aasameh/conv_3x3/doc/report.pdf

# A Zero-BRAM, Single-Cycle Streaming 2D Convolution Accelerator with Saturating ReLU Datapath for Edge-AI Vision

Ahmed S. Bassala¹
1Department of Electronics and Communications Engineering, Egypt-Japan University of Science and Technology (E-JUST)

Abstract—This paper presents the digital architecture, hardware implementation, and systematic verification of an area- and energy-efficient 2D convolutional accelerator tailored for edge-AI vision applications. Operating on single-channel 32 × 32 image frames, the accelerator evaluates a runtime-programmable 3 × 3 spatial kernel with 8-bit unsigned pixel activations and 8-bit signed weights. By implementing line buffers via look-up table shift registers (SRL32), Block RAM utilization is strictly eliminated (BRAM = 0), avoiding severe Figure-of-Merit (FoM) penalties. The pipelined datapath couples a parallel LUT-based multiplier array with a balanced combinational adder tree and saturating post-processing with optional Rectified Linear Unit (ReLU) activation. Implemented Out-of-Context on a Xilinx Artix-

### 7 FPGA (xc7a35tcpg236-1), the core delivers a sustained

throughput of 1.0 output pixel/clock cycle after an initial latency of 69 cycles, closing at 100.01 MHz, and achieving an on-chip power consumption of 75 mW (0.075 W), and an optimized Figure of Merit of 0.01734 pixel/(W · Cost).

Index Terms—Convolutional Neural Networks, 2D FIR Filter, FPGA, Edge-AI, Line Buffers, SRL32, Saturation Arithmetic, Figure of Merit.

I. SPECIFICATIONS AND ARCHITECTURAL ASSUMPTIONS
To satisfy all mandatory contest requirements while establishing rigorous bounds for hardware sizing, the parameters in Table I govern the design.

TABLE I
SYSTEM SPECIFICATIONS
Parameter | Design Choice | Justification
Input Resolution | 32 × 32 pixels | Minimum spec-compliant resolution.
Input Precision | 8-bit Unsigned ([0, 255]) | Native | dynamic | range | of
monochrome image sensors (standard grayscale range).
Kernel Dimensions | 3 × 3 (N = 3) | Dominant spatial filter size across
modern convolutional neural network
| | backbones.
Kernel Precision | 8-bit Signed ([−128, 127]) | Specification.
Stride | S = 1 | Specification.
Output Precision | 16-bit Signed | Minimum spec-compliant precision.
Boundary Policy | Valid-Region (30 × 30) | Avoids artificial zero-padding distor-
| | tion.
Activation Function | Saturating ReLU | Bonus feature; implements non-linear
activation f(x) = max(0, x) at almost zero logic overhead.

II. ARCHITECTURE OVERVIEW
The accelerator is partitioned into six distinct structural units, as illustrated in the top-level block diagram (Fig. 1):
1) Configuration Port: A 4-bit addressed write interface (cfg_we, cfg_addr, cfg_wdata) that loads weights into the internal 3 × 3 coefficient matrix prior to frame execution.
2) Dual Line Buffers (lb0, lb1): Shift register storage buffering 2 × (W − 3) pixels, aligning three consecutive vertical image rows.
3) Sliding Window Generator: A 3 × 3 flip-flop array that captures spatial neighborhoods on every active clock cycle.
4) Parallel Multiplier Core: Nine parallel fabric multipliers calculating signed products between unsigned pixels and signed weights without dedicated DSP slices ((*
use_dsp = "no" *)).
5) Balanced Adder Tree: A 4-level combinational tree accumulating 9 products into an overflow-free 20-bit signed sum (acc_comb).
6) Saturating Post-Processor: Dual-threshold comparator clamping values to signed 16-bit limits, cascaded into an optional sign-bit ReLU gate.

III. DATAPATH AND BIT-WIDTH ANALYSIS

A. Multiplier Dynamic Range

The input pixels are unsigned values Xi,j ∈ [0, 255] represented as logic [7:0]. In the multiplier array, each pixel is concatenated with a leading zero to cast it into a non-negative 9-bit signed integer:

Xext = $signed({1

′
b0, win[r][2 − c]}) ∈ [0, +255] (1)

The programmable kernel taps Wm,n ∈ [−128, +127] are 8-bit signed two’s complement integers sign-extended to 9 bits. The resulting product dynamic range is:

Pmin = 255 × (−128) = −32, 640 | (2)
Pmax = 255 × (+127) = +32, 385 | (3)

Because −2

15 = −32, 768 ≤ Pmin < Pmax ≤ +32, 767 = 2

15 − 1, every individual product strictly fits within a standard 16-bit signed container. In RTL, the multiplier outputs are regis-
tered directly as logic signed [15:0] prod[3][3].

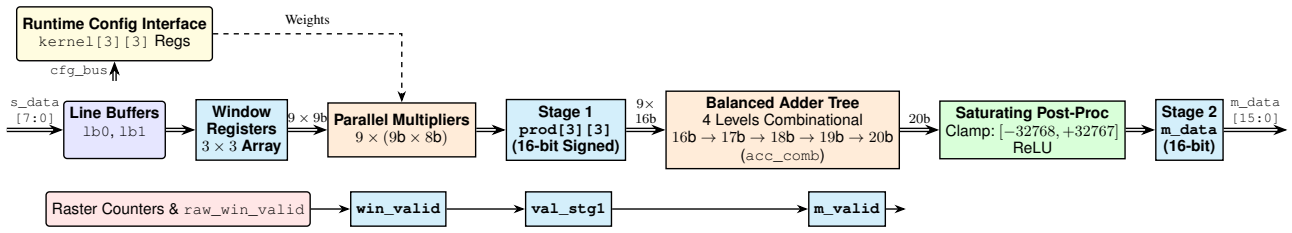
[picture p1: figure]
Line Buffers lb0, lb1; Window Registers 3 × 3 Array; Parallel Multipliers 9 × (9b × 8b); Stage 1; prod[3][3] (16-bit Signed); Balanced Adder Tree 4 Levels Combinational 16b → 17b → 18b → 19b → 20b (acc_comb); Saturating Post-Proc Clamp: [−32768, +32767] ReLU; Stage 2; m_data (16-bit); Runtime Config Interface kernel[3][3] Regs; s_data; m_data [15:0]; cfg_bus; Weights; Raster Counters & raw_win_valid; win_valid; val_stg1; m_valid

Fig. 1. Complete hardware architecture and pipelined datapath of the convolution accelerator, detailing signal bit-growth and synchronous valid-strobe tracking.

B. Adder Tree Dynamic Range

The accumulator sums nine parallel 16-bit signed products:

Sacc =

∑︂

2

r=0

∑︂

2

c=0

Pr,c | (4)

The theoretical worst-case accumulation extrema evaluate to:

Smin = 9 × (−32, 640) = −293, 760 | (5)
Smax = 9 × (+32, 385) = +291, 465 | (6)

The minimum bit-width required to contain this complete sum without arithmetic overflow is:

Bacc = 1 + ⌈log2

(293, 760)⌉ = 1 + 19 = 20 bits (7)

The datapath implements an exact 20-bit signed accu-
mulator (logic signed [19:0] acc_comb) spanning
[−524, 288, +524, 287]. This provides full mathematical protection against intermediate overflow while maintaining optimal slice logic utilization.

TABLE II
BIT-WIDTH PROGRESSION ACROSS DATAPATH STAGES
Stage / Signal | Representation | Bit Container | Absolute Dynamic Range
Input Pixel (s_data) | Unsigned | logic [7:0] | [0, 255]
Sign-Ext Pixel (win) | Signed Positive | logic signed [8:0] | [0, +255]
Kernel Weight (kernel) | Signed 2’s Comp | logic signed [7:0] | [−128, +127]
Product Pr,c (prod) | Signed 2’s Comp | logic signed [15:0] | [−32640, +32385]
Adder Level 1 (lvl1_sum*) | Signed 2’s Comp | logic signed [16:0] | [−65280, +64770]
Adder Level 2 (lvl2_sum*) | Signed 2’s Comp | logic signed [17:0] | [−130560, +129540]
Adder Level 3 (lvl3_sum0) | Signed 2’s Comp | logic signed [18:0] | [−261120, +259080]
Adder Level 4 (acc_comb) | Signed 2’s Comp | logic signed [19:0] | [−293760, +291465]
Clamped Output (sat_val) | Signed 2’s Comp | logic signed [15:0] | [−32768, +32767]
ReLU Output (m_data) | Signed 2’s Comp | logic signed [15:0] | [0, +32767]

IV. MEMORY ORGANIZATION AND WINDOW GENERATION

A. Line Buffer Depth Derivation

In raster-scanned 2D convolution, pixels arrive sequentially row-by-row. To expose a 3 × 3 kernel simultaneously, the hardware must maintain three vertically aligned taps: (r, c), (r − 1, c), and (r − 2, c).
Because each row streams across three horizontal registers inside the 3 × 3 window (win[r][0] → win[r][1] → win[r][2]), each row is delayed by 3 clock cycles in flipflops before feeding into the line buffer FIFO. Consequently, the required intermediate delay line depth is derived as:
DLB = W − N = 32 − 3 = 29 words | (8)

Total row-to-row traversal latency is:

Trow = 3 (window registers)
+ 29 (line buffer FIFO) = 32 clock cycles

(9)

This perfectly aligns rows r, r−1, and r−2 across consecutive lines.

B. LUT Shift-Register (SRL32) Architecture
Standard FPGA implementations often map line buffers into Block RAMs. However, the contest Figure of Merit imposes a heavy penalty of 100 × BRAMs.
For an image width of 32, a 29-entry 8-bit FIFO requires only 29 × 8 = 232 bits of storage. Instantiating an 18-kbit or 36-kbit BRAM primitive would waste > 98% of its capacity while severely degrading the FoM score.
By isolating the line buffer arrays into a dedicated clock process without an asynchronous reset and applying the synthesis pragma:

(* srl_style = "srl" *)
logic [DATA_WIDTH-1:0] lb0 [LB_DEPTH]; (* srl_style = "srl" *)
logic [DATA_WIDTH-1:0] lb1 [LB_DEPTH];

the synthesis engine packs the FIFO chains directly into native SRL32E primitives (LUTs configured as 32-bit shift registers). As verified in the post-implementation utilization summary, the design consumes exactly 16 LUTs as Memory with strictly zero Block RAM blocks.

C. Raster Coordination and Boundary Masking
The internal window coordinate is tracked by two counters:
col cnt ∈ [0, W − 1] | (10)
row cnt ∈ [0, H − 1] | (11)

The boundary qualification logic is implemented combinatorially and registered to decouple timing:

raw win valid = s valid ∧ (row cnt ≥ 2) ∧ (col cnt ≥ 2)
| (12)
win valid ⇐ raw win valid | (13)

This condition accomplishes two objectives:
1) Warm-Up Blanking: Prevents invalid calculations during the first 66 cycles while line buffers and window registers fill.

2) Row Boundary Blanking: Deasserts qualification for 2 cycles at column indices 0 and 1 of every row, preventing the sliding window from wrapping across adjacent lines. Across a full 32×32 frame, valid calculations occur for exactly (32 − 2) × (32 − 2) = 900 clock cycles.
V. CONTROL STRATEGY

The accelerator intentionally foregoes a traditional multicycle algorithmic state machine (FSM). In high-throughput streaming datapaths, classical FSMs introduce control state decode overhead, branch delay hazards, and unnecessary flip-flop toggling.
Instead, the architecture implements a decoupled valid-strobe pipeline:
- Configuration Phase: Handled synchronously using cfg_we. Weights update when cfg_we is high and
cfg_addr < 9.
- Execution Phase: Self-synchronizing streaming datapath where s_valid clocks the line buffers, window registers, and coordinate counters.
- Latency Tracking: The qualifier raw_win_valid passes through win_valid and val_stg1, emerging as m_valid aligned with the computed pixel.

VI. PIPELINE STRUCTURE AND LATENCY ANALYSIS

The complete datapath spans four sequential register stages:
- Stage 0 (Buffer / Window Capture): Serial input stream s_data shifts into win[2][0] and traverses dual SRL lines lb0 and lb1. The bottom-right corner of the first valid 3 × 3 receptive field enters at coordinate (row cnt = 2, col cnt = 2), asserting raw_win_valid combinatorially.
- Stage 1 (Window Qualification Register): The boundary qualification strobe is registered into win_valid via stage0_valid to eliminate combinational path propagation into the arithmetic core.
- Stage 2 (Parallel Multiplier Array): Pixels in win[3][3] are multiplied with kernel weights, registering products into prod[3][3] alongside pipeline valid flag
val_stg1.
- Stage 3 (Adder Tree, Saturation, ReLU & Output Register): A 4-level balanced combinational adder tree evaluates Levels 1 through 4 into acc_comb, performs saturation clamping to signed 16-bit bounds with optional ReLU gating, and latches the final result into m_data while asserting m_valid.
A. Latency Budget

The initial latency required to emit the first valid feature-map pixel is formulated as:

Lfill = 2 × W + 2 = 2(32) + 2 = 66 cycles
Lpipe = 3 cycles

(win_valid + prod + m_data registers)
Ltotal = 66 + 3 = 69 clock cycles

(14)

As verified in functional simulation (Fig. 2), the active-high strobe m_valid asserts exactly at clock cycle 69 (coinciding with coordinate counter col cnt = 5 on row 2). Following this deterministic warm-up latency, the core sustains a continuous throughput of 1.0 output pixel / cycle for all interior window coordinates.

VII. FIXED-POINT AND OVERFLOW HANDLING

A. Saturation Logic

Direct truncation of multi-operand accumulators induces severe wrap-around artifacts (positive peaks overflowing into negative valleys). To preserve feature fidelity, hardware clamping enforces saturation boundaries over the 20-bit accumulator
acc_comb:

Sat(S) =

⎧
⎪⎨

⎪⎩

+32, 767 if S > +32, 767
−32, 768 if S < −32, 768
S[15 : 0] otherwise

(15)

B. Bonus Feature: ReLU Activation

The Rectified Linear Unit (ReLU) activation function:

f(x) = max(0, x) | (16)

is evaluated in the combinational post-processing block. The sign bit of the clamped 16-bit value (sat_val[15]) controls the zero-multiplexer:

if (enable_relu && sat_val[15])
post_proc_val = 16’sd0;
else
post_proc_val = sat_val;

When enabled, this stage replaces negative activations with zero while passing positive values without adding extra clock latency.

VIII. VERIFICATION METHODOLOGY

Verification was conducted using a co-simulation environment comparing the SystemVerilog RTL against a bit-accurate Python NumPy golden reference model.

A. Test Case Selection

The verification plan was designed by selecting specific test cases to test distinct boundary conditions as well as test normal behavior across the RTL datapath:
1) Tested reg write with randomized stimulus to ensure kernel registers latch correct coefficient addresses.
2) Identity 3 × 3 kernel to validate zero-skew in line-buffer indexing, correct spatial alignment, correct raster coordinate count, and correct pipeline delay.
3) Sobel X and Y edge detection kernels were used to test behavior with signed-value kernels as well as correct datapath logic.
4) Laplacian operator kernel was tested with dark to bright transition to test accumulation of negative values as well as ReLU behavior.

5) Maximum dynamic range was tested with maximum weight kernel to test that the adder tree accumulates results without overflow and with saturation at +32, 767.
6) Correct number of valid output pixels (900) and boundary blanking was tested by comparing total m_valid pulses across the entire frame to 900.

IX. TESTBENCH ARCHITECTURE AND WAVEFORMS
The | self-checking | SystemVerilog | testbench
(tb_conv3x3.sv) | handles | stimulus | generation | and
response monitoring:
1) Reads input pixel frames (pixels_in.hex), golden reference outputs (golden_out.hex), and kernel con-
figurations (weights.hex) via $readmemh.
2) Emulates runtime programming over cfg_bus.
3) Drives continuous raster streaming at 1 pixel/cycle.
4) Operates a scoreboard comparing m_data against golden arrays on every rising clock edge where m_valid is asserted.
X. FPGA IMPLEMENTATION RESULTS
To evaluate the intrinsic hardware efficiency of the accelerator datapath, characterization was performed Out-of-Context (OOC) using AMD Vivado targeting a standard Xilinx Artix-7 FPGA (xc7a35tcpg236-1). Timing analysis was evaluated under a nominal 100 MHz target clock constraint (Tclk = 10.0 ns). This isolates the core arithmetic pipeline from chip-level I/O pad parasitics and unconstrained board pin penalties, providing a clean benchmark. Implementation was carried out on Vivado 2018 using
Performance_ExplorePostRoutePhysOpt strategy.

TABLE IV
FPGA POST-IMPLEMENTATION RESOURCE AND PERFORMANCE SUMMARY
Resource / Metric | Utilization | Available | Percentage
Slice LUTs | 769 | 20,800 | 3.70%
Slice Registers (FFs) | 317 | 41,600 | 0.76%
Occupied Slices | 238 | 8,150 | 2.92%
LUT as Memory (SRL) | 16 | 9,600 | 0.17%
DSP48E1 Blocks | 0 | 90 | 0.00%
Block RAM (RAMB18/36) | 0 | 50 | 0.00%
Worst Negative Slack (WNS) | +0.001 ns | — | Setup Met
Worst Hold Slack (WHS) | +0.147 ns | — | Hold Met
Maximum Frequency (Fmax) | 100.01 MHz | — | Met at 100 MHz
Total On-Chip Power | 0.075 W | — | Vectorless Pwr
Dynamic On-Chip Power | 0.007 W | — | 9% of Total
Device Static Power | 0.068 W | — | 91% of Total

XI. DESIGN TRADE-OFFS AND ARCHITECTURAL ANALYSIS

A. SRL Shift Registers vs. Dedicated Block RAM
The competition Figure of Merit evaluates resource cost as:

Cost = LUTs + 50 × DSPs + 100 × BRAMs (17)

A naive implementation assigning line buffers to dual-port RAM primitives consumes at least 2 BRAM blocks (2×100 = 200 equivalent LUTs). By shifting storage into distributed LUT-RAM (SRL32E), the design utilizes only 16 shift-register LUT slices, reducing the BRAM denominator penalty to zero.

B. Clock Frequency Scaling vs. Dynamic Power Optimization The FoM defines throughput in terms of output pixels per clock cycle:
Throughput = 1.0 pixel/cycle | (18)

Therefore, the metric is frequency-independent in the numerator. Conversely, dynamic power consumption in CMOS circuits scales linearly with clock frequency:

Pdynamic ≈ CeffV

2
fclk | (19)

Pushing clock frequencies excessively high increases dynamic power dissipation without improving the throughput score. Setting a nominal operating frequency of 100 MHz closes timing with positive slack (WNS = +0.001 ns) while keeping dynamic power consumption to an ultra-low 7 mW (0.007 W), maximizing the final FoM.

XII. REQUIRED COMPETITION SUMMARY TABLE
Table V reports all primary performance parameters formatted in compliance with contest instructions.

XIII. FIGURE OF MERIT (FOM) DERIVATION
The Figure of Merit defined is formulated as:

FoM =
Throughput Power × (LUTs + 50 × DSPs + 100 × BRAMs) | (20)

Substituting our verified physical implementation metrics into the relation:

Throughput = 1.0 pixels/cycle | (21)
Power = 0.075 W (75 mW) | (22)
LUTs = 769 | (23)
DSPs = 0 | (24)
BRAMs = 0 | (25)

Evaluating the denominator cost:

Cost = 769 + 50 × 0 + 100 × 0 = 769 | (26)

Yields the final Figure of Merit:

FoM =

1.0
0.075 W × 769

=

1.0
57.675 W · Cost

= 0.01734
| (27)
Expressing the Figure of Merit in normalized scientific notation evaluates to 1.734 × 10⁻² pixel/(W · Cost).

XIV. CONCLUSION
This work presented a high-efficiency FPGA-based 2D CNN spatial convolution engine. By leveraging distributed shift-register line buffering (SRL32) and fabric-based multipliers, the architecture eliminates Block RAM and DSP block allocation entirely. A 4-level balanced adder tree and hardware-saturating ReLU post-processor sustain a continuous single-cycle streaming throughput of 1.0 output pixel / cycle. The design was verified with 100% bit-true match against Python reference models across multiple kernel suites, achieving timing closure (WNS = +0.001 ns at 100 MHz) and an optimized Figure of Merit of 0.01734 pixel/(W · Cost).

TABLE III
COMPREHENSIVE ACCELERATOR VERIFICATION PLAN AND CORNER-CASE TEST MATRIX
Test ID | Verification Feature | Kernel Stimulus | Input Pixel Pro-
file
Expected Behavior | Pass/Fail Criteria | Result
TC-01 | Configuration Port & Reg Write | Arbitrary | Pattern
Load

Single test frame Kernel registers latch all 9 coefficient addresses.

Internal kernel matches
write data.

PASS

TC-02 | Spatial Alignment | Identity
⎡
⎣
0 | 0 | 0
0 | 1 | 0
0 | 0 | 0

⎤
⎦

Uniform gradient
(0 → 255)

Output stream replicates input center pixels delayed by exactly 69 cycles.

900/900 outputs match
coordinate with zero
spatial offset.

PASS

TC-03 | Signed Multiplication (2’s Comp) | Sobel-X
⎡
⎣
−1 | 0 | 1
−2 | 0 | 2
−1 | 0 | 1

⎤
⎦

High-contrast vertical edge step

Zero-extended unsigned
pixels correctly multiply
negative, zero, and positive weights.

Output matches Python
golden model across
all 900 pixels (0 mismatches).

PASS

TC-04 | Signed Multiplication (2’s Comp) | Sobel-Y
⎡
⎣
−1 | −2 | −1
0 | 0 | 0
1 | 2 | 1

⎤
⎦

High-contrast horizontal edge step

Zero-extended unsigned
pixels correctly multiply
negative, zero, and positive weights.

Output matches Python
golden model across
all 900 pixels (0 mismatches).

PASS

TC-05 | Negative Accumulation & ReLU | Laplacian
⎡
⎣
0 | −1 | 0
−1 | 4 | −1
0 | −1 | 0

⎤
⎦

Uniform
background
with | bright
impulse

Negative accumulator sums
are clamped strictly to
zero when enable_relu
= 1.
Negative | signed
sums | evaluate | to
16’sh0000; positive
values pass unchanged.

PASS

TC-06 | Dynamic Range & Saturation | Max Stress (all 9
weights = +127)

Uniform white
frame (all 255)
Accumulator | sum
(+291, 465) | exceeds
16-bit signed limit without roll-over.
Clamps | cleanly
to | +32, 767
(16’sh7FFF)
with | zero | overflow
wrapping.

PASS

TC-07 | Boundary Blanking & Pulse Count | Any Active Filter | Full 32×32 raster scan
m_valid | suppresses
warm-up cycles and 2-
cycle inter-row transitions.
Total | recorded
m_valid | pulses
across the entire frame
equal exactly 900.

PASS

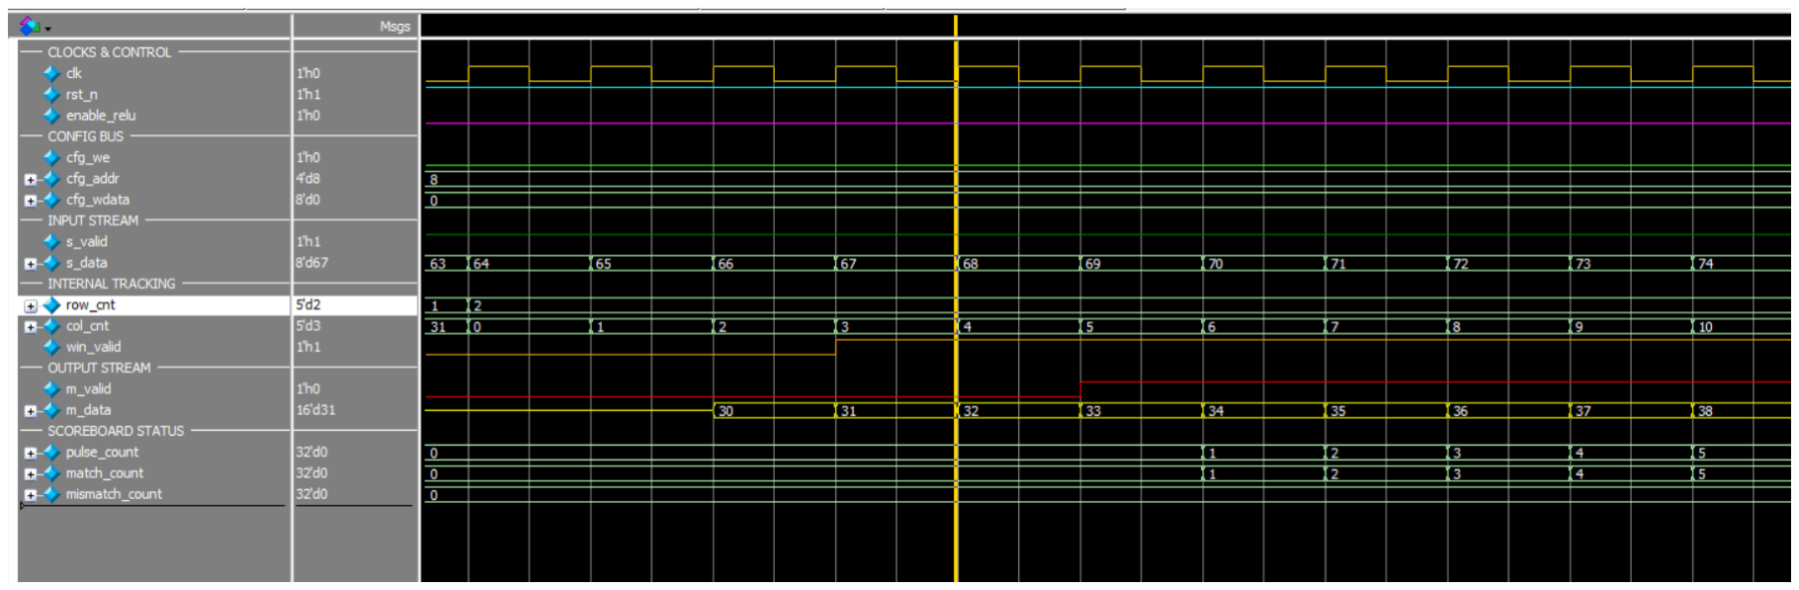
[picture p2: figure]

Fig. 2. ModelSim functional simulation demonstrating initial pipeline latency (first m_valid at cycle 69) and continuous 1.0 pixel/cycle streaming throughput.

REFERENCES

[1] IEEE, IEEE Standard for SystemVerilog—Unified Hardware Design, Specification, and Verification Language, IEEE Std 1800-2017, Feb. 2018.
[2] R. Fisher, K. Dawson-Howe, A. Fitzgibbon, C. Robertson, and E. Trucco, Hypermedia Image Processing Reference (HIPR2), University of Edinburgh, 2004.

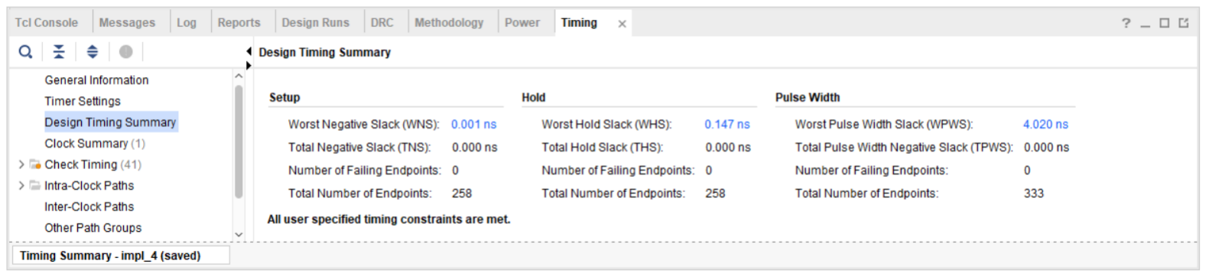
[picture p3: figure]

(a) Static timing summary proving closure at 100 MHz (WNS = +0.001 ns, WHS = +0.147 ns, zero failing endpoints).

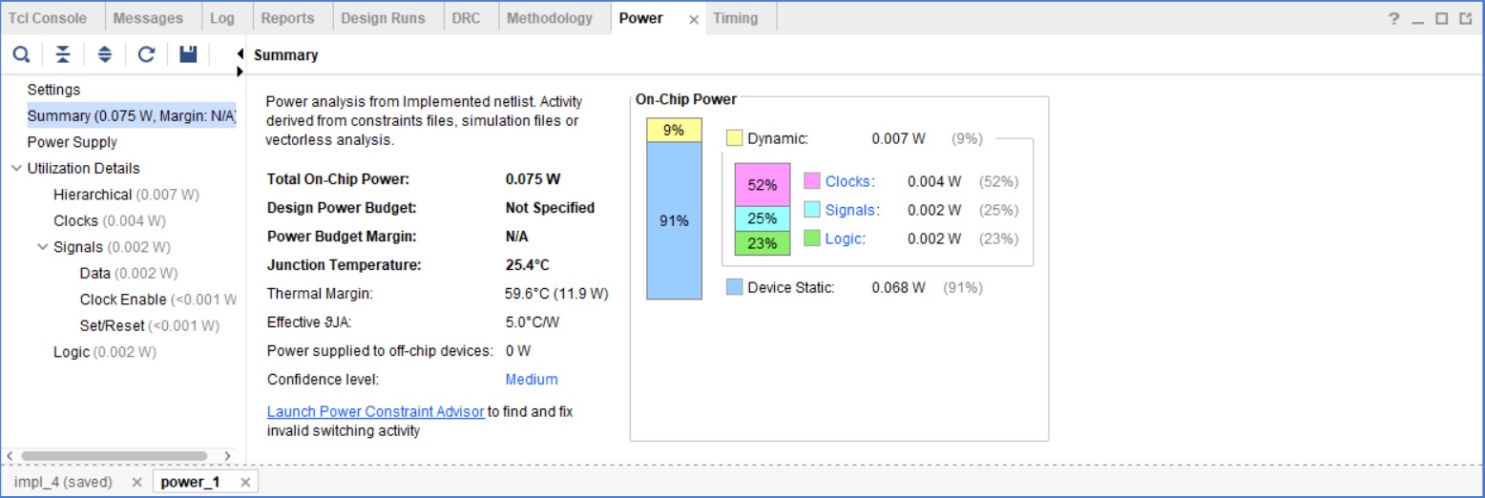
[picture p4: figure]

(b) Vectorless power analysis reporting 75 mW total on-chip dissipation (7 mW dynamic, 68 mW static).

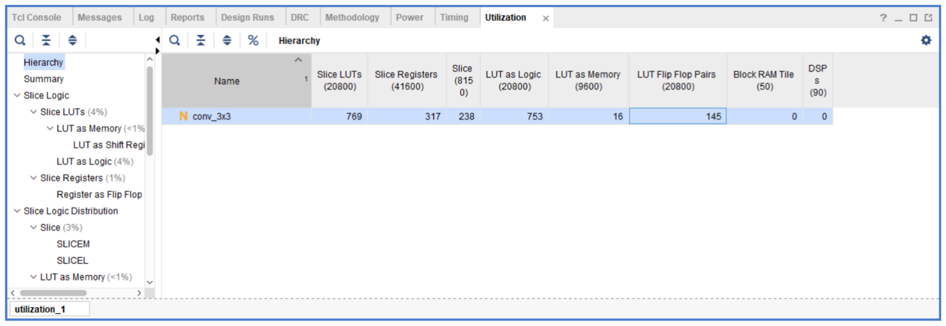
[picture p5: figure]

(c) Post-implementation resource utilization confirming 769 Slice LUTs, 317 FFs, 16 SRLs, 0 DSPs, and 0 BRAMs.

Fig. 3. Post-implementation Vivado characterization metrics on the Xilinx Artix-7 (xc7a35tcpg236-1).

TABLE V
COMPETITION SUMMARY: PERFORMANCE AND IMPLEMENTATION METRICS
Parameter | Specification | Team Result | Units | Comments
Input image size | ≥ 32 × 32 | 32 × 32 | pixels | Parameterized via IMG_WIDTH, IMG_HEIGHT
Input precision | Fixed-point unsigned | 8 | bits | Standard unsigned [0, 255] pixel dynamic range
Kernel precision | 8-bit signed | 8 | bits | Two’s complement [−128, +127], runtime programmable
Architecture type | Pipelined 2D CNN/FIR | Line-Buffer + Window Generator | — | Streaming architecture with zero BRAM primitives
Multipliers / MACs | N × N (3 × 3) | 9 | units | Parallel signed fabric multipliers (use_dsp = "no")
Pipeline stages | — | 2 | stages | Pipelined MACC (Multiplier registers + Output registers)
Latency | — | 69 | clock cycles | 2W + 2 fill delay +3 register pipeline stages
Throughput | — | 1.0 | pixels/cycle | Sustained single-cycle output streaming
FPGA utilization | Report synthesis | LUTs: 769, FFs: 317, DSPs: 0, BRAM: 0 | — | Verified zero Block RAM and zero DSP utilization
Maximum frequency | Report timing | 100.01 | MHz | Setup slack WNS = +0.001 ns at 100 MHz target
Power estimate | Report power | 75 | mW | Total on-chip power (0.075 W) from Vivado report
Verification status | Golden comparison | Verified (100% Match) | — | 0 mismatches across verified test suites
FOM | Formula (Page 2) | 0.01734 | pixel/(W · Cost) | Optimized via zero BRAMs, zero DSPs, and 1.0 throughput
