aasameh/conv_3x3/doc/implemented_device.png

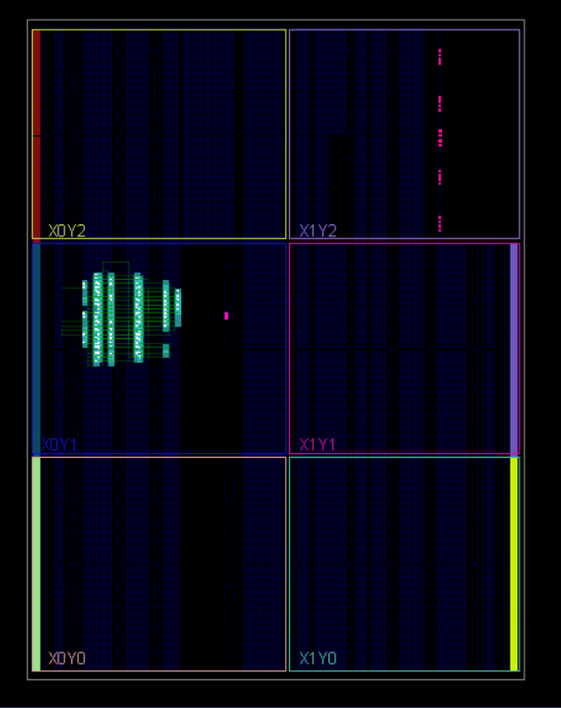
doc/implemented_device.png
