aasameh/conv_3x3/doc/waveform.png

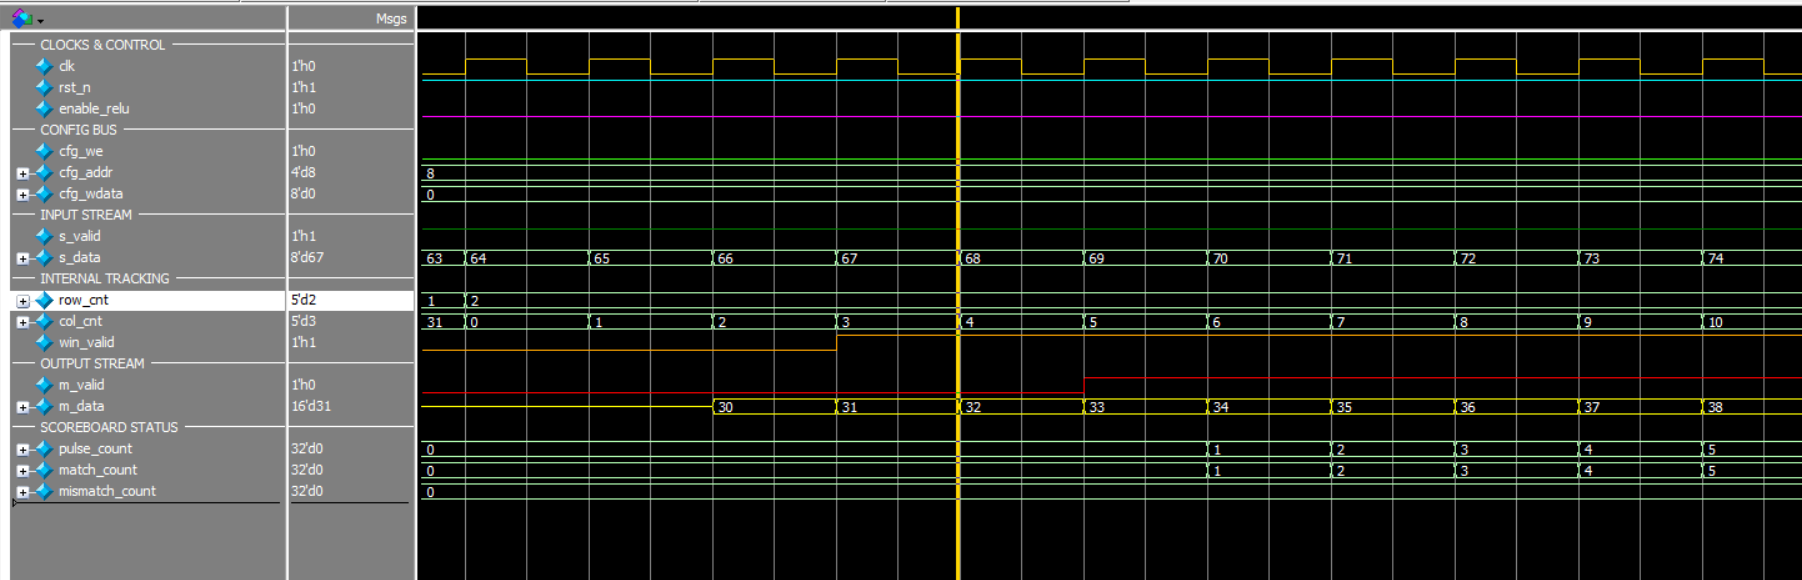
doc/waveform.png
