aasameh/conv_3x3/syn/implementation.pdf

## LUT6 O

## LUT6 O

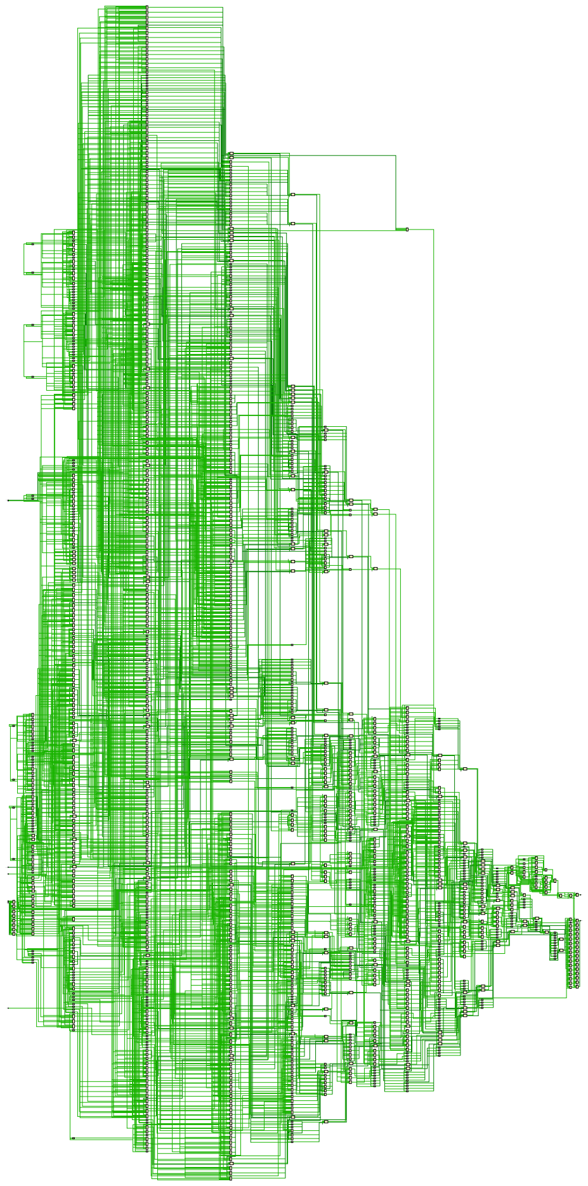
[picture p9: page 1]
cfg_addr[3:0] cfg_we; cfg_wdata[7:0]; rst_n; clk s_valid s_data[7:0]; enable_relu; prod[2][0][10]_i_31; LUT2; prod[2][0][2]_i_9; prod[2][1][10]_i_31; prod[2][1][2]_i_9; win_reg[2][0][0] FDCE Q C CECLR Dwin_reg[2][0][1] FDCE Q C; CECLR Dwin_reg[2][0][2] FDCE Q C; CECLR Dwin_reg[2][0][3] FDCE Q C; CECLR Dwin_reg[2][0][4] FDCE Q C; CECLR Dwin_reg[2][0][5] FDCE Q C; CECLR Dwin_reg[2][0][6] FDCE Q C; CECLR Dwin_reg[2][0][7] FDCE Q C; CECLR D; prod[1][2][2]_i_9; prod[1][2][10]_i_31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
